andrewjchen/exynos-backpack/models/ltc4352_load_switch_min.asc

C1: cap; .1µ
C2: cap; .1µ
C9: cap; 100µ
C10: cap; 0.1µ
C11: cap; 0.1µ
C15: cap; 10µ
D_nFAULTA: LED; NSPW500BS
D_nSTATA: LED; NSPW500BS
I1: current; 3
Q1: nmos; Si7234DP
Q5: nmos; Si7234DP
R1: res; 750
R2: res; 750
R7: res; 3.6k
R8: res; 2k
R9: res; 27k
U1: LTC4352
V_BATTA: voltage; PULSE(0 3.05 0.5 1u 1u 1); Rser=0.050
Named nets: 0, V_BATTA, V_LOAD
.tran 3 uic
.options gmin=1e-10 abstol=1e-10 reltol=0.003 cshunt=1e-15
