andrewjchen/exynos-backpack/models/ltc4352_load_switch.asc

C1: cap; .1µ
C2: cap; .1µ
C3: cap; 0.1µ
C4: cap; .1µ
C5: cap; .1µ
C6: cap; 0.1µ
C7: cap; .1µ
C8: cap; .1µ
C9: cap; 100µ
C10: cap; 0.1µ
C11: cap; 0.1µ
C12: cap; 0.1µ
C13: cap; 0.1µ
C14: cap; 10µ
C15: cap; 10µ
C16: cap; 10µ
D_nFAULTA: LED; NSPW500BS
D_nFAULTB: LED; NSPW500BS
D_nFAULTW: LED; NSPW500BS
D_nSTATA: LED; NSPW500BS
D_nSTATB: LED; NSPW500BS
D_nSTATW: LED; NSPW500BS
I1: current; 3
Q1: nmos; Si7234DP
Q2: nmos; Si7234DP
Q3: nmos; Si7234DP
Q4: nmos; Si7234DP
Q5: nmos; Si7234DP
Q6: nmos; Si7234DP
R1: res; 750
R2: res; 750
R3: res; 750
R4: res; 750
R5: res; 750
R6: res; 750
R7: res; 3.6k
R8: res; 2k
R9: res; 27k
R10: res; 27k
R11: res; 3.6k
R12: res; 2k
R13: res; 910
R14: res; 2.7k
R15: res; 27k
U1: LTC4352
U2: LTC4352
U3: LTC4352
V_BATTA: voltage; PULSE(0 4.2 0.5 1u 1u 1); Rser=0.050
V_BATTB: voltage; 3.0
V_WALL: voltage; PULSE(0 6 2.25 1u 1u 0.4); Rser=0.050
Named nets: 0, V_WALL, V_BATTA, V_BATTB, V_LOAD
.tran 3 uic
.options gmin=1e-10 abstol=1e-10 reltol=0.003 cshunt=1e-15
