andrewjchen/exynos-backpack/models/ltc4412_load_switch.asc

C1: cap; 10µ
Q1: PMOS; FDC638P
Q2: PMOS; FDC638P
Q3: PMOS; FDC638P
R1: res; 470k
R2: res; 470k
R3: res; 470k
Rload: res; 1
U1: LTC4412
U2: LTC4412
U3: LTC4412
V_BATTA: VOLTAGE; PWL(0 4.2 1 3.0 2.99 3.0 3 0)
V_BATTB: VOLTAGE; PWL(0 0 1.99 0 2 4.2)
V_WALL: voltage; PWL(0 0 3.99 0 4 5.5)
Named nets: 0, V_OUT, STAT_A, STAT_B, V_BATTA, V_BATTB, V_WALL, STAT_WALL
.tran 6
