andrewjchen/exynos-backpack/usb-breakout.brd

## EAGLE design usb-breakout.brd (2013-02-28)

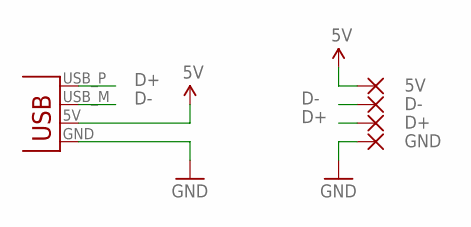
[picture p1: schematic usb-breakout.sch]

Parts:
JP1: USBPCB; USB-A-PCB
PAD1: GND; 5-1,8
PAD2: D+; 5-1,8
PAD3: D-; 5-1,8
PAD4: 5V; 5-1,8

Connections:
5V: JP1.5V (VBUS), PAD4.1
D+: JP1.USB_P (D+), PAD2.1
D-: JP1.USB_M (D-), PAD3.1
GND: JP1.GND, PAD1.1

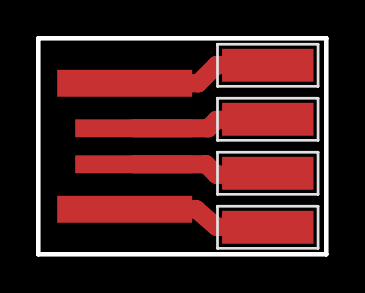
[picture p2: board usb-breakout.brd from above]

Board: 2 copper layers, 16.0 x 12.0 mm, 5 parts (0 on the bottom side), 4 nets.
