andrewjchen/exynos-backpack/exynos-backpack.brd

## EAGLE design exynos-backpack.brd (2013-02-28)

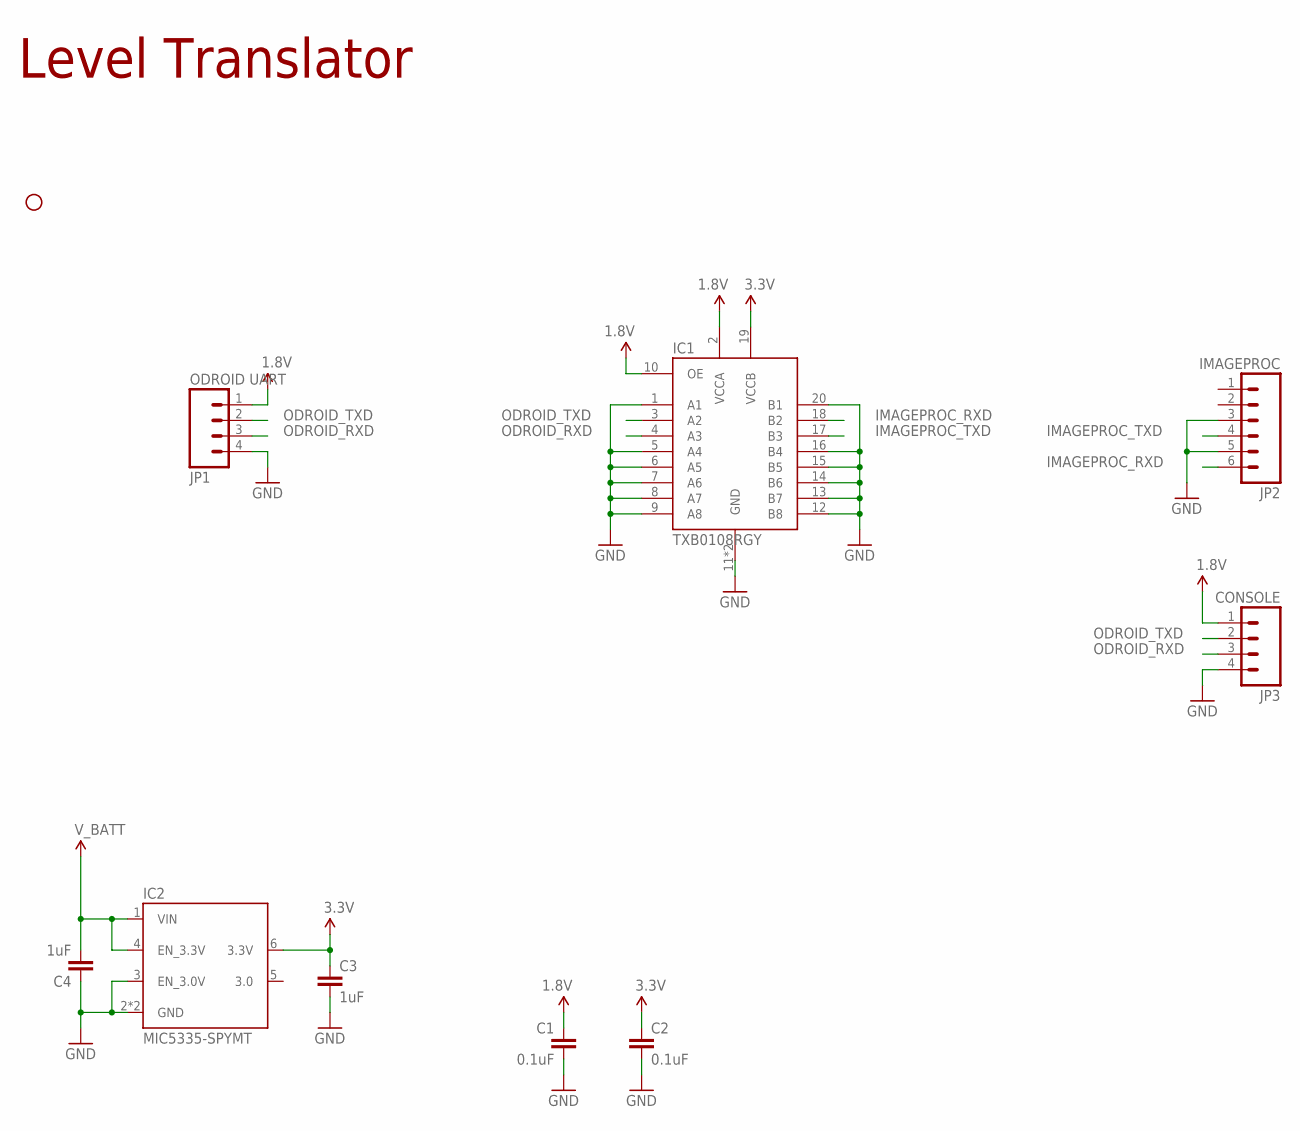
[picture p3: schematic exynos-backpack.sch, sheet 1, Level Translator]

Parts:
C1, C2: 0.1uF; 0402-CAP
C3, C4: 1uF; 0402-CAP
IC1: TXB0108RGY; R-PVQFN-N20
IC2: MIC5335-SPYMT; MLF-6
JP1: ODROID UART; 1X04_MOLEX_5267_NOSILK
JP2: IMAGEPROC; MOLEX_503480-0600
JP3: CONSOLE; 1X04_MOLEX_5267
U$2: ODROID-U2; ODROID-U2-KEEPOUT

Connections:
1.8V: C1.1, IC1.2 (VCCA), IC1.10 (OE), JP1.1, JP3.1
3.3V: C2.1, C3.1, IC1.19 (VCCB), IC2.6 (3.3V)
GND: C1.2, C2.2, C3.2, C4.1, IC1.1 (A1), IC1.5 (A4), IC1.6 (A5), IC1.7 (A6), IC1.8 (A7), IC1.9 (A8), IC1.11 (GND), IC1.12 (B8), IC1.13 (B7), IC1.14 (B6), IC1.15 (B5), IC1.16 (B4), IC1.20 (B1), IC1.EPAD (GND), IC2.2 (GND), IC2.3 (EN_3.0V), IC2.EPAD (GND), JP1.4, JP2.3, JP2.5, JP3.4; also elsewhere on the board
IMAGEPROC_RXD: IC1.18 (B2), JP2.6
IMAGEPROC_TXD: IC1.17 (B3), JP2.4
ODROID_RXD: IC1.4 (A3), JP1.3, JP3.3
ODROID_TXD: IC1.3 (A2), JP1.2, JP3.2
V_BATT: C4.2, IC2.1 (VIN), IC2.4 (EN_3.3V); also elsewhere on the board

Notes on the sheet:
Level Translator

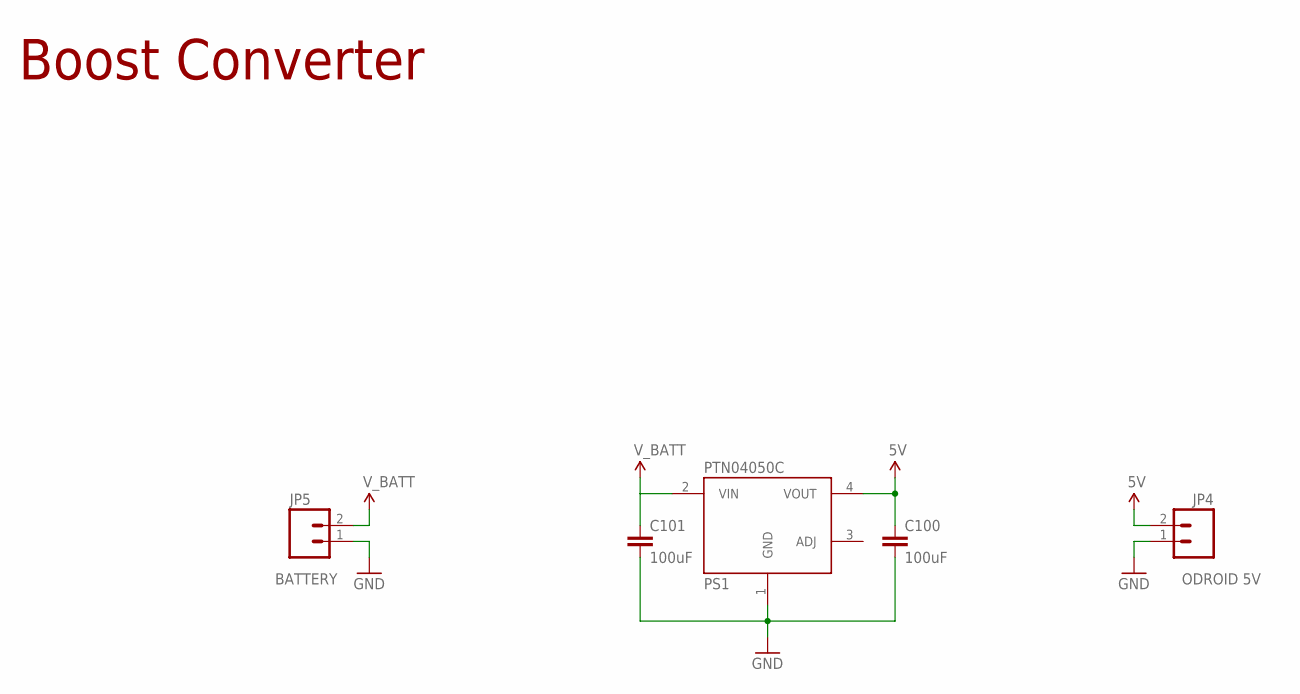
[picture p4: schematic exynos-backpack.sch, sheet 2, Boost Converter]

Parts:
C100, C101: 100uF; 1210
JP4: ODROID 5V; JST-RCY-FEMALE_NOSILK
JP5: BATTERY; JST-RCY-MALE_NOSILK
PS1: PTN04050C

Connections:
5V: C100.1, JP4.2, PS1.4 (VOUT)
GND: C100.2, C101.2, JP4.1, JP5.1, PS1.1 (GND); also elsewhere on the board
V_BATT: C101.1, JP5.2, PS1.2 (VIN); also elsewhere on the board

Notes on the sheet:
Boost Converter

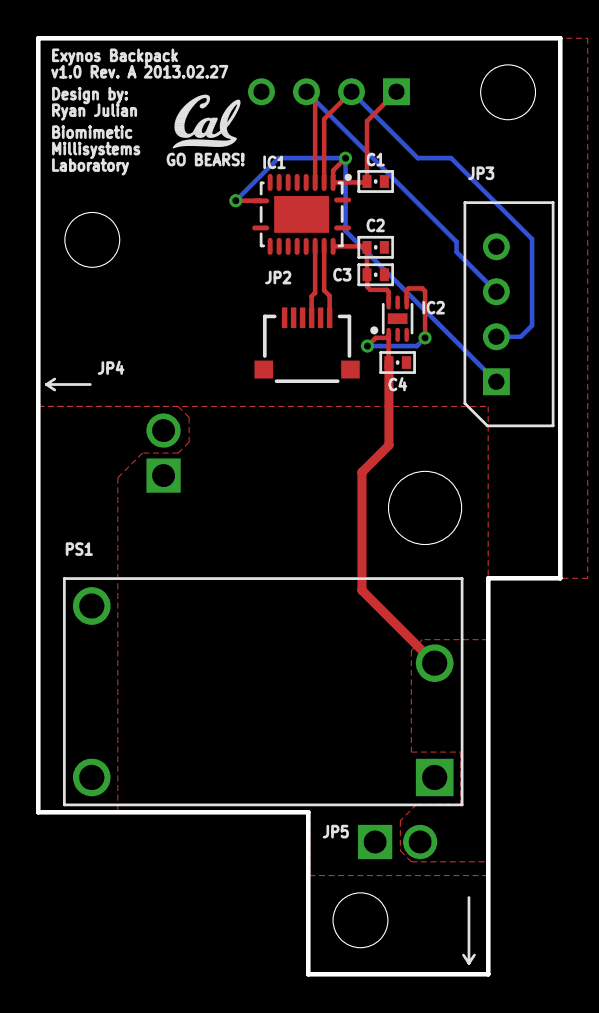
[picture p5: board exynos-backpack.brd from above]

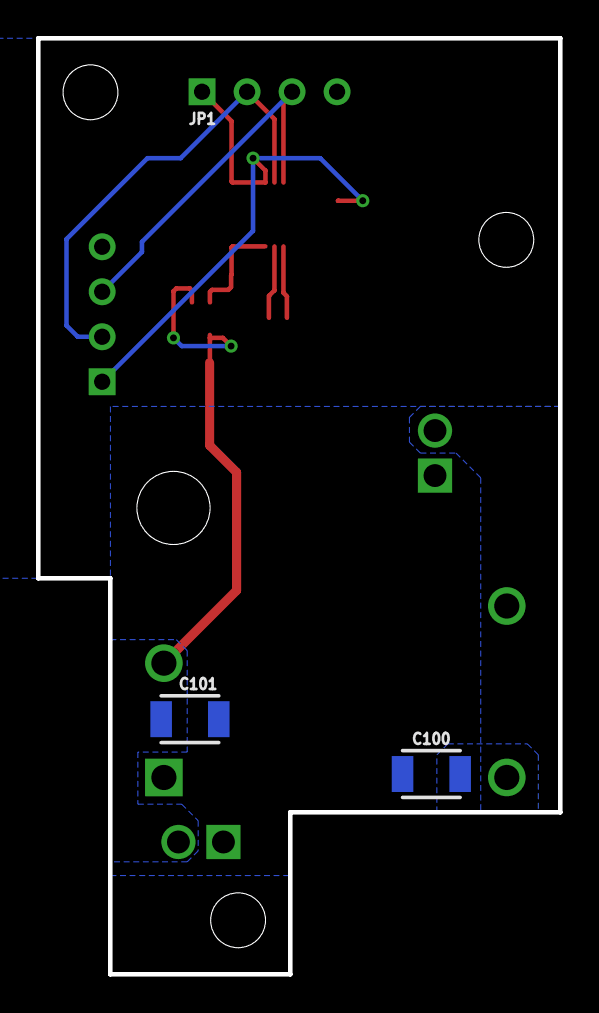
[picture p6: board exynos-backpack.brd from below]

Board: 4 copper layers, 29.0 x 52.0 mm, 16 parts (2 on the bottom side), 9 nets.

Other parts of the board:
$$U$1: CAL_LOGO
