andrewjchen/exynos-backpack/power-distribution.brd

## EAGLE design power-distribution.brd (2013-02-25)

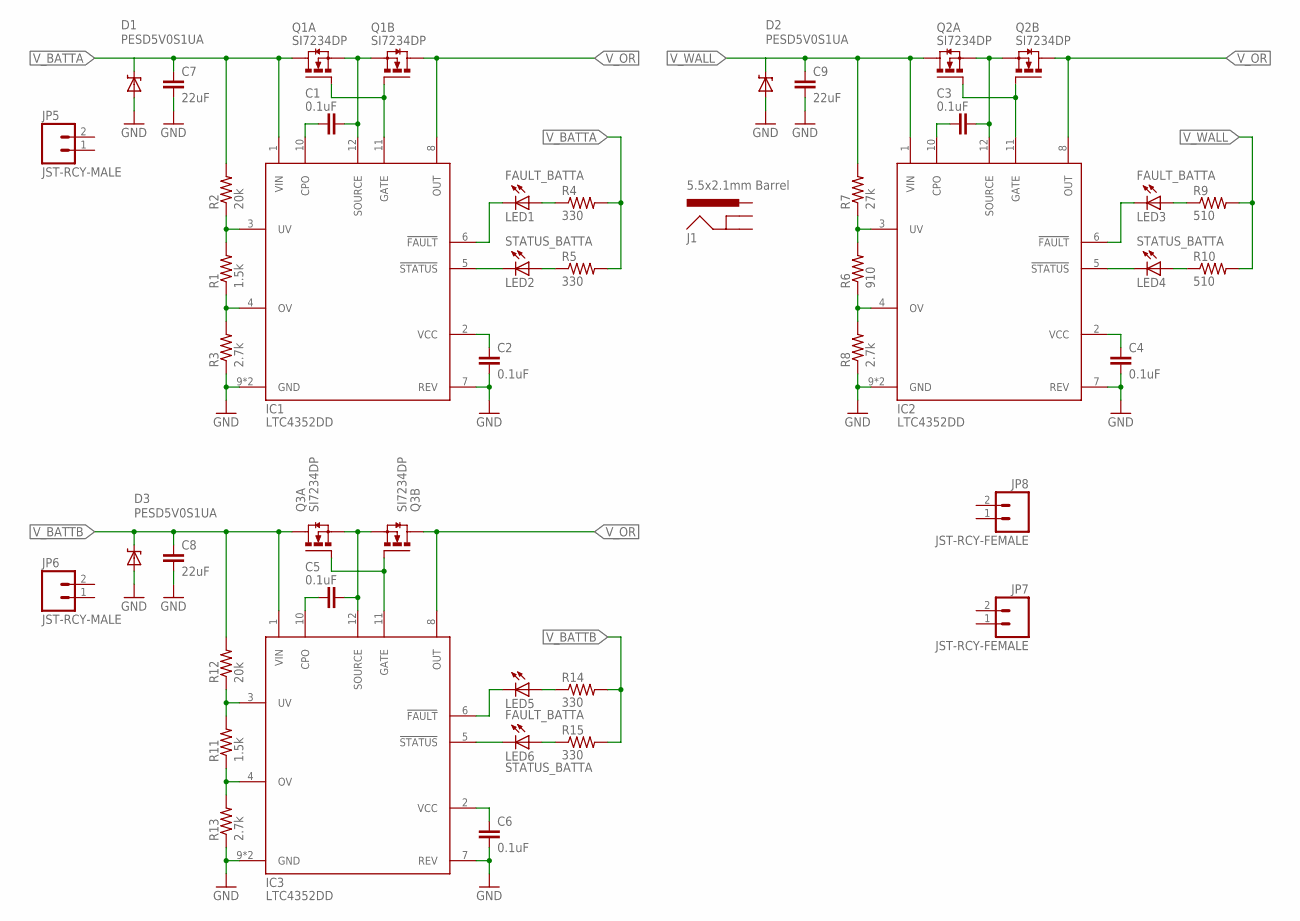
[picture p7: schematic power-distribution.sch, Power Hot Swap]

Parts:
C1, C2, C3, C4, C5, C6: 0.1uF; 0402-CAP
C7, C8, C9: 22uF; 0603-CAP
D1, D2, D3: PESD5V0S1UA; SOD-323
IC1, IC2, IC3: LTC4352DD; DFN-12-3X3-DD
J1: 5.5x2.1mm Barrel; POWER_JACK_SMD
JP5, JP6: JST-RCY-MALE
JP7, JP8: JST-RCY-FEMALE
LED1, LED3, LED5: FAULT_BATTA; LED-0603
LED2, LED4, LED6: STATUS_BATTA; LED-0603
Q1, Q2, Q3: SI7234DP; POWERPAK-SO-8-DUAL
R1, R11: 1.5k; 0402-RES
R2, R12: 20k; 0402-RES
R3, R8, R13: 2.7k; 0402-RES
R4, R5, R14, R15: 330; 0402-RES
R6: 910; 0402-RES
R7: 27k; 0402-RES
R9, R10: 510; 0402-RES

Connections:
GND: C2.2, C4.2, C6.2, C7.2, C8.2, C9.2, D1.2 (A), D2.2 (A), D3.2 (A), IC1.7 (REV), IC1.9 (GND), IC1.PAD (GND), IC2.7 (REV), IC2.9 (GND), IC2.PAD (GND), IC3.7 (REV), IC3.9 (GND), IC3.PAD (GND), R3.1, R8.1, R13.1
unnamed: C1.2, IC1.12 (SOURCE), Q1.1 (S), Q1.3 (S)
unnamed: IC1.11 (GATE), Q1.2 (G), Q1.4 (G)
unnamed: C1.1, IC1.10 (CPO)
unnamed: IC1.3 (UV), R1.2, R2.1
unnamed: IC1.4 (OV), R1.1, R3.2
unnamed: C2.1, IC1.2 (VCC)
unnamed: IC1.6 (!FAULT), LED1.C
unnamed: IC1.5 (!STATUS), LED2.C
unnamed: LED2.A, R5.1
unnamed: LED1.A, R4.1
unnamed: C3.2, IC2.12 (SOURCE), Q2.1 (S), Q2.3 (S)
unnamed: IC2.11 (GATE), Q2.2 (G), Q2.4 (G)
unnamed: C3.1, IC2.10 (CPO)
unnamed: IC2.3 (UV), R6.2, R7.1
unnamed: IC2.4 (OV), R6.1, R8.2
unnamed: C4.1, IC2.2 (VCC)
unnamed: IC2.6 (!FAULT), LED3.C
unnamed: IC2.5 (!STATUS), LED4.C
unnamed: LED4.A, R10.1
unnamed: LED3.A, R9.1
unnamed: C5.2, IC3.12 (SOURCE), Q3.1 (S), Q3.3 (S)
unnamed: IC3.11 (GATE), Q3.2 (G), Q3.4 (G)
unnamed: C5.1, IC3.10 (CPO)
unnamed: IC3.3 (UV), R11.2, R12.1
unnamed: IC3.4 (OV), R11.1, R13.2
unnamed: C6.1, IC3.2 (VCC)
unnamed: IC3.6 (!FAULT), LED5.C
unnamed: IC3.5 (!STATUS), LED6.C
unnamed: LED6.A, R15.1
unnamed: LED5.A, R14.1
V_BATTA: C7.1, D1.1 (C), IC1.1 (VIN), Q1.7+8 (D), R2.2, R4.2, R5.2
V_BATTB: C8.1, D3.1 (C), IC3.1 (VIN), Q3.7+8 (D), R12.2, R14.2, R15.2
V_OR: IC1.8 (OUT), IC2.8 (OUT), IC3.8 (OUT), Q1.5+6 (D), Q2.5+6 (D), Q3.5+6 (D)
V_WALL: C9.1, D2.1 (C), IC2.1 (VIN), Q2.7+8 (D), R7.2, R9.2, R10.2

Board: 4 copper layers, 45 parts (34 on the bottom side), 35 nets, no tracks yet.

Other parts of the board:
U$12: CAL_LOGO
