andrewjchen/exynos-backpack/(commit log)

2013-02-14 Initial commit with partial schematic and SPICE
    [exynos-backpack.brd, exynos-backpack.sch]
2013-02-14 Use VBATT instead of Vout for LEDs in min model
2013-02-15 Update MOSFETs to Si7234DP in SPICE
    [exynos-backpack.brd, exynos-backpack.sch]
2013-02-15 Add ODROID-U2 drawing
    [exynos-backpack.sch]
2013-02-15 Add TVS protection diodes
    [exynos-backpack.sch]
2013-02-15 Add boost converter
    [exynos-backpack.sch]
2013-02-16 Unswap OV/UV resistors
2013-02-16 Reduce current-limiting resistor values
    [exynos-backpack.sch]
2013-02-16 Adjust Rlim on LiPo ideal-OR LEDs down to 330
    [exynos-backpack.sch]
2013-02-16 Change OV/UV resistors to Robert Ou's values
    [exynos-backpack.sch]
2013-02-17 Rearrange LED circuits in schematic
    [exynos-backpack.sch]
2013-02-18 Add JST connectors
    [exynos-backpack.sch]
2013-02-23 Update footprint to avoid connectors
2013-02-25 More work on backpack placement
    [exynos-backpack.brd, exynos-backpack.sch]
2013-02-25 Split power distribution into its own PCB
    [power-distribution.brd, power-distribution.sch]
2013-02-26 First pass at exynos backpack placement
    [exynos-backpack.brd, exynos-backpack.sch]
2013-02-26 Finish placement
    [exynos-backpack.brd, exynos-backpack.sch]
2013-02-27 Revise footprint for correct ethernet connector size
    [exynos-backpack.brd, exynos-backpack.sch]
2013-02-27 Add hole for encoder cable
    [exynos-backpack.brd]
2013-02-27 Revise placement for new dimension
    [exynos-backpack.brd]
2013-02-27 Route serial section
    [exynos-backpack.brd]
2013-02-27 Routing complete
    [exynos-backpack.brd]
2013-02-27 Arrange silkscreen
    [exynos-backpack.brd, exynos-backpack.sch]
2013-02-27 Disable 3.0v supply
    [exynos-backpack.brd]
2013-02-27 Renumber components for silk
    [exynos-backpack.brd, exynos-backpack.sch]
2013-02-27 Fix via overlap with silk
    [exynos-backpack.brd]
2013-02-28 Add USB breakout board
    [exynos-backpack.brd, usb-breakout.brd, usb-breakout.sch]
