andrewjchen/exynos-backpack/(notices)

Notices in the files:
parts and their libraries:
biomimetic: UC Regents. All rights reserved.
SparkFun-Connectors: Licensing: CC v3.0 Share-Alike You are welcome to use this library for commercial purposes.
